felipe-mcarvalho/Embarcatech-3Fase/README.md

# SoC RISC-V com Acelerador AES-128 - Embarcatech 3ª Fase

Este repositório contém o projeto final da 3ª Fase do programa Embarcatech. O sistema consiste em um System-on-Chip (SoC) baseado no processador RISC-V (PicoRV32), integrado a um acelerador criptográfico de hardware para o algoritmo AES-128 e controlado externamente via interface serial (UART). O projeto foi sintetizado e validado fisicamente em uma FPGA Lattice ECP5 (Colorlight i9).

## Visão Geral do Projeto
Abaixo estão representados o diagrama da arquitetura lógica instanciada no SoC e a montagem física do sistema na placa FPGA.

Diagrama RTL
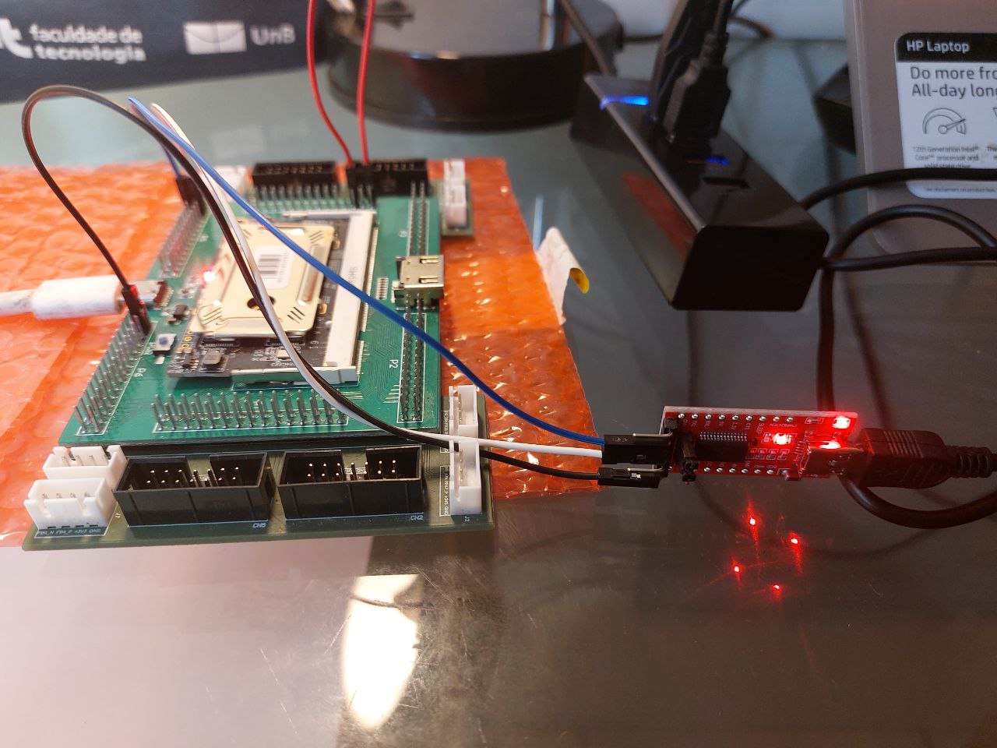
[picture p1: docs/img/placa1.jpg]
Foto do Projeto


---

## Estrutura do Repositório

- `rtl/`: Códigos-fonte em Verilog descrevendo o hardware (CPU, AES, UART, Interconexões).
- `firmware/`: Códigos em linguagem C e Linker Scripts executados pelo PicoRV32.
- `sim/`: Arquivos de testbench e simulação.
- `scripts/`: Scripts auxiliares de automação.
- `validation/`: Scripts em Python.
- `Makefile`: Automação da compilação do firmware.
- `docs/`: Documentação de referência, imagens e diagramas.

---

## Demonstrações em Vídeo
Clique nas thumbnails abaixo para visualizar os testes na placa:

Validação módulo AES (https://www.youtube.com/watch?v=sAaSfQWxbzg)
Validação RISC-V (https://www.youtube.com/watch?v=2NX07yqfi-U)

## Visão Física e Layout
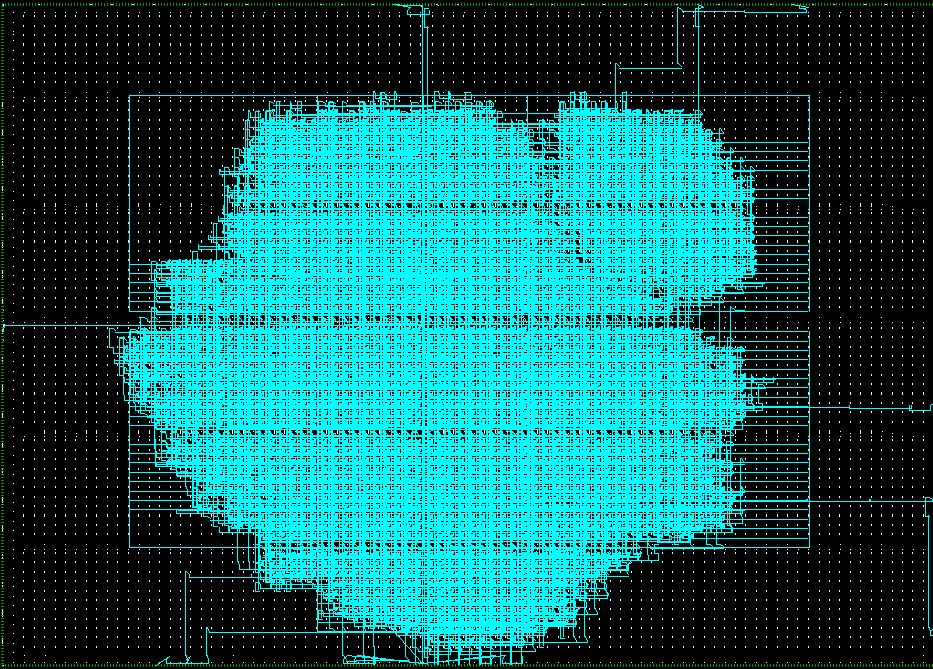
[picture p2: docs/img/soc_top_physical_view.png]
Physical View do SoC com o PicoRV32


## Simulação: Bloco AES
Validação dos vetores de teste matemáticos da criptografia.
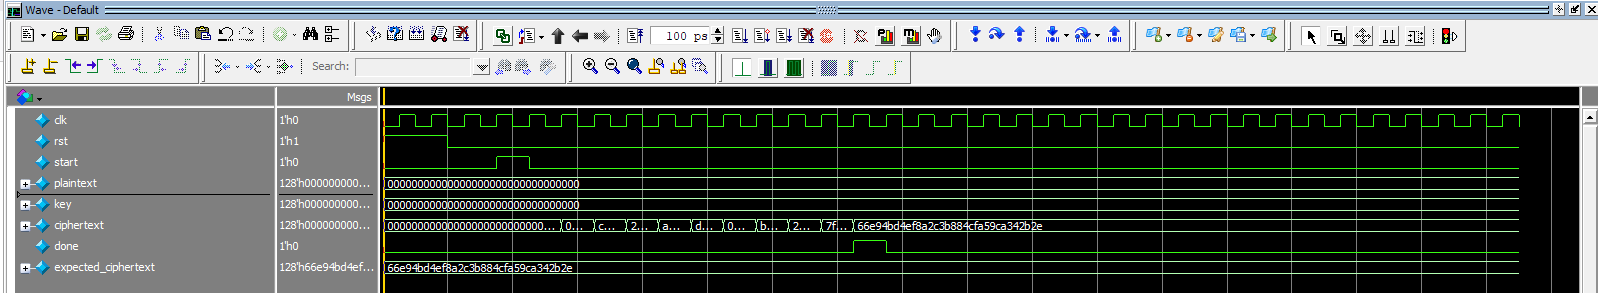
[picture p3: docs/img/tb_aes1.png]
Testbench AES 1

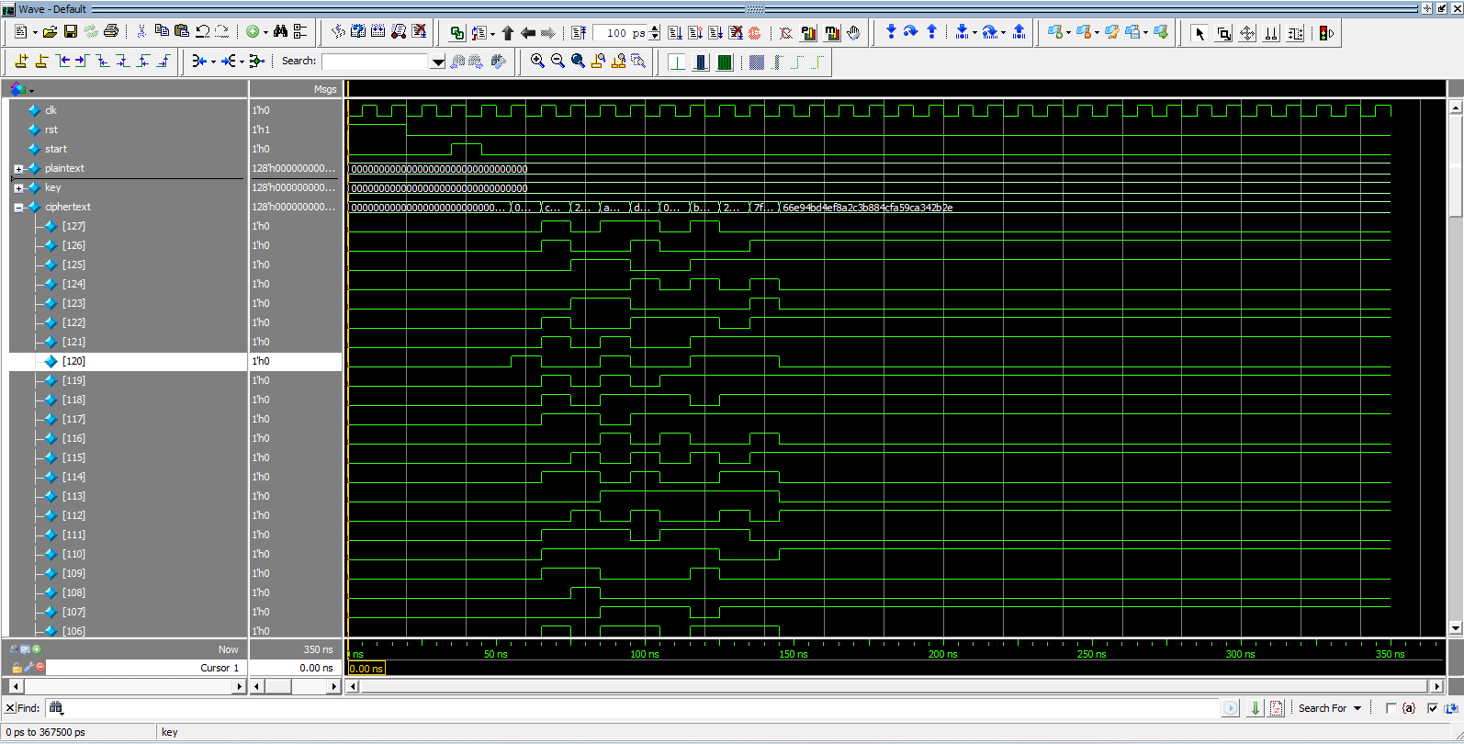
[picture p4: docs/img/tb_aes2.png]
Testbench AES 2

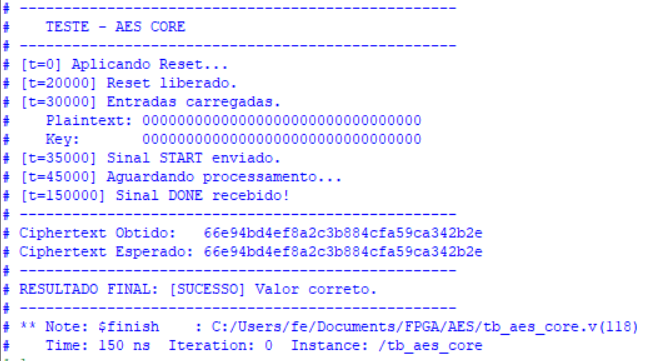
[picture p5: docs/img/tb_aes3.png]
Testbench AES 3


## Simulação: SoC PicoRV32
Execução de código e validação das instruções do processador RISC-V.
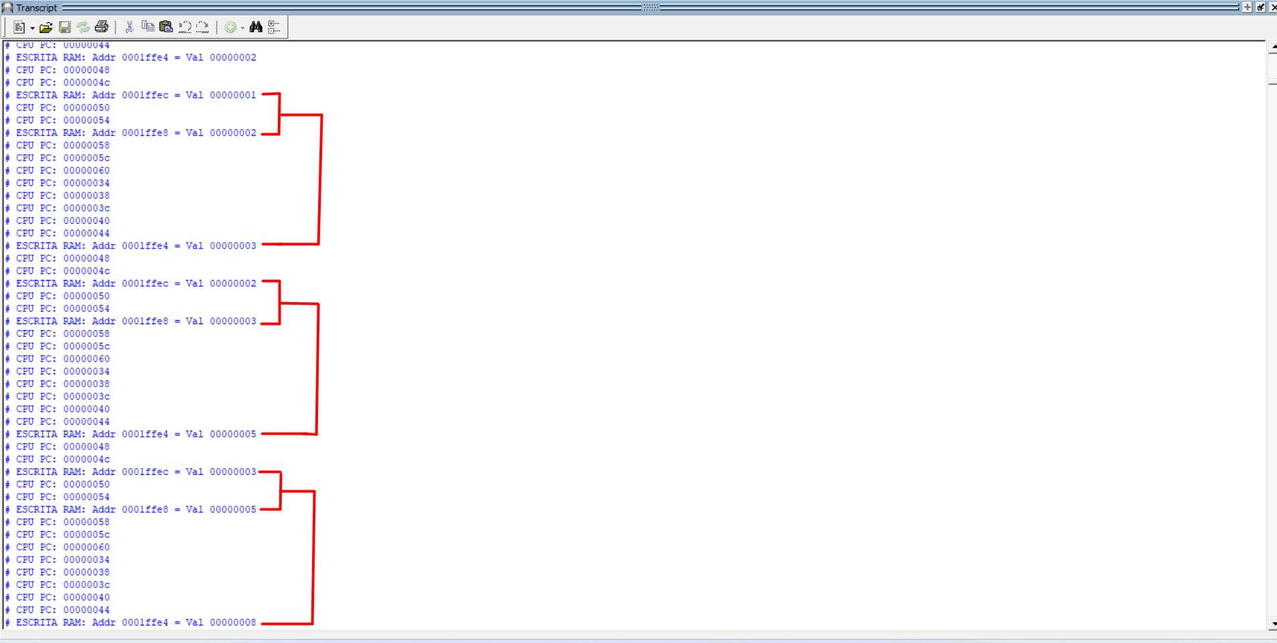
[picture p6: docs/img/tb_pico1.png]
Testbench PicoRV32 1

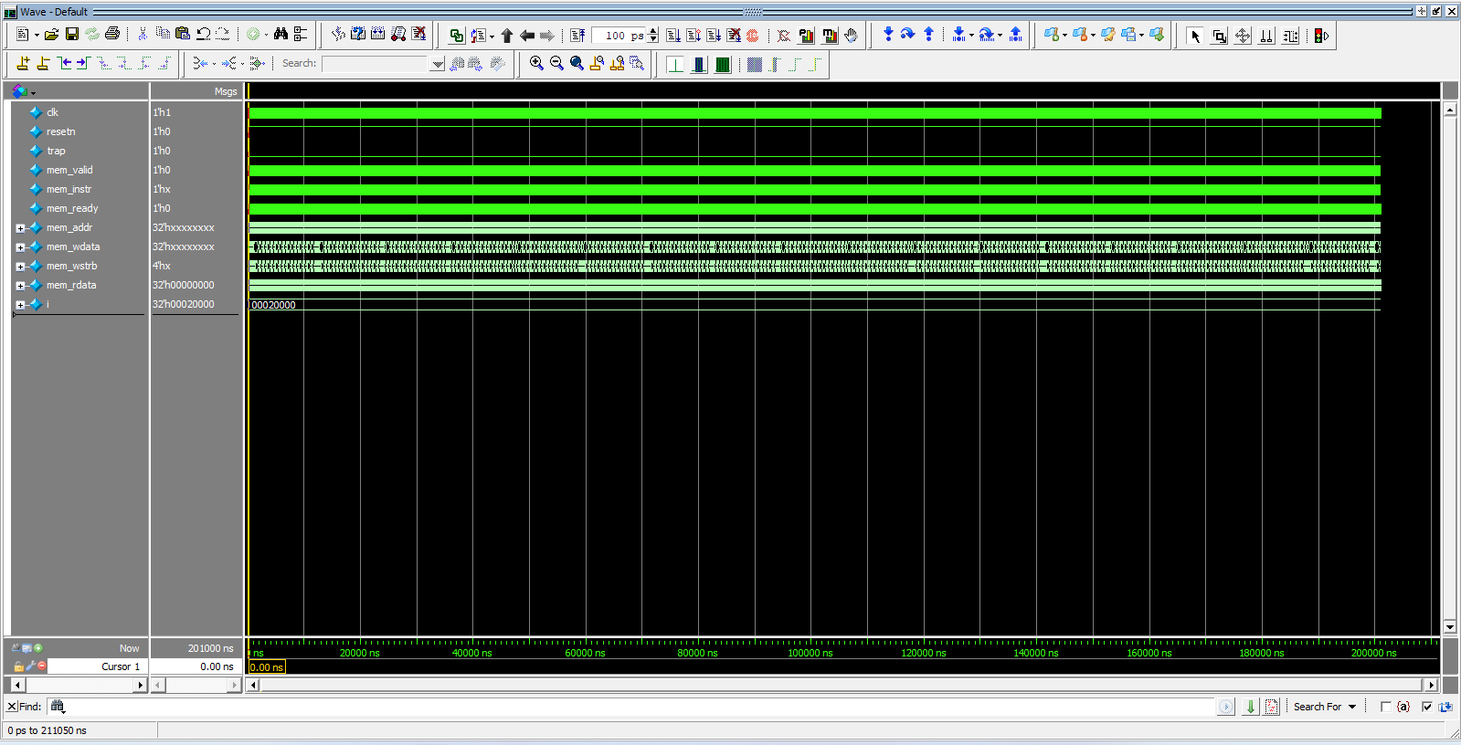
[picture p7: docs/img/tb_pico2.png]
Testbench PicoRV32 2

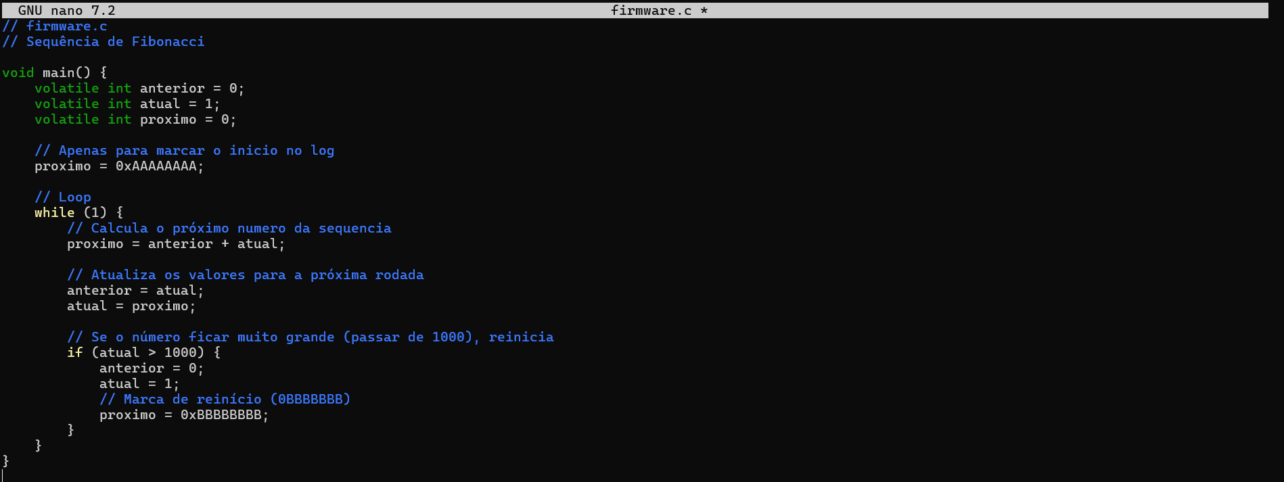
[picture p8: docs/img/tb_pico3.png]
Testbench PicoRV32 3


## Comunicação UART
Teste de transmissão e recepção serial.
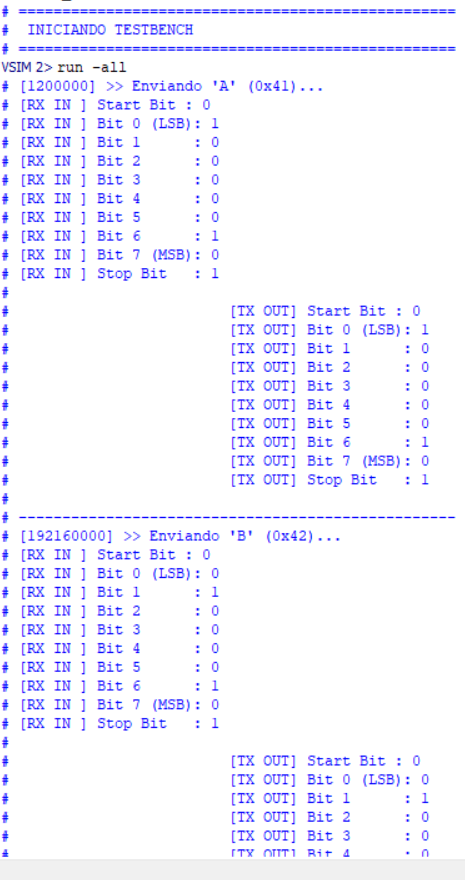
[picture p9: docs/img/tb_uart1.png]
Testbench UART

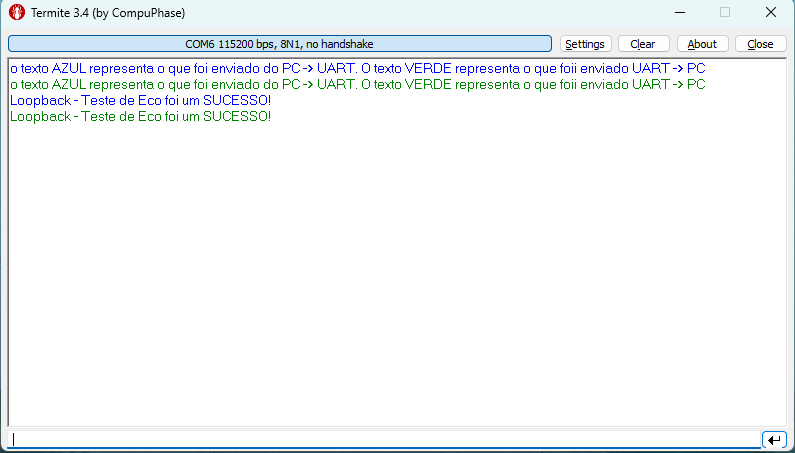
[picture p10: docs/img/teste_uart_sintetizada.png]
Teste UART sintetizada na colorlight-i9

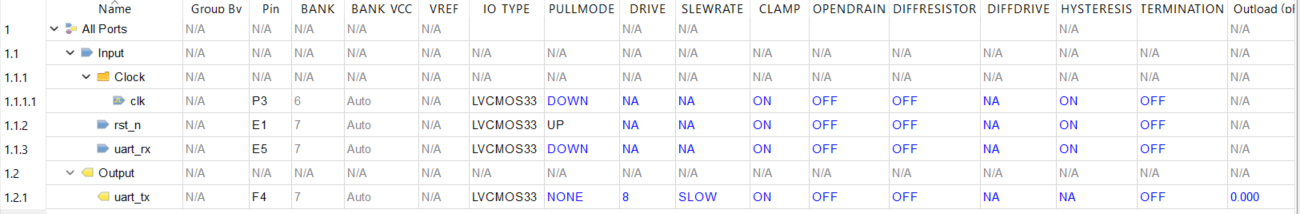
[picture p11: docs/img/pinagem_uart.png]
Pinagem UART


## Erros da Placa (Debug)
erro1
erro2
