felipe-mcarvalho/Embarcatech-3Fase/docs/add_round_key_rtl.pdf

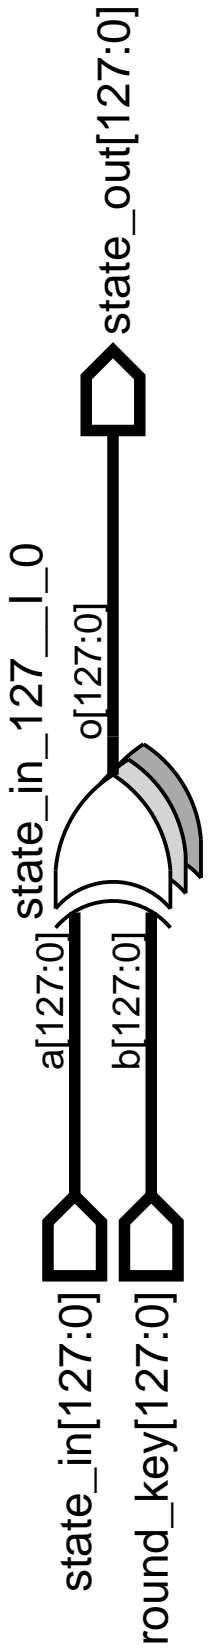
[picture p13: figure]
state_in[127:0]; state_in_127__I_0; round_key[127:0]; state_out[127:0]
