felipe-mcarvalho/Embarcatech-3Fase/docs/round_top_rtl.pdf

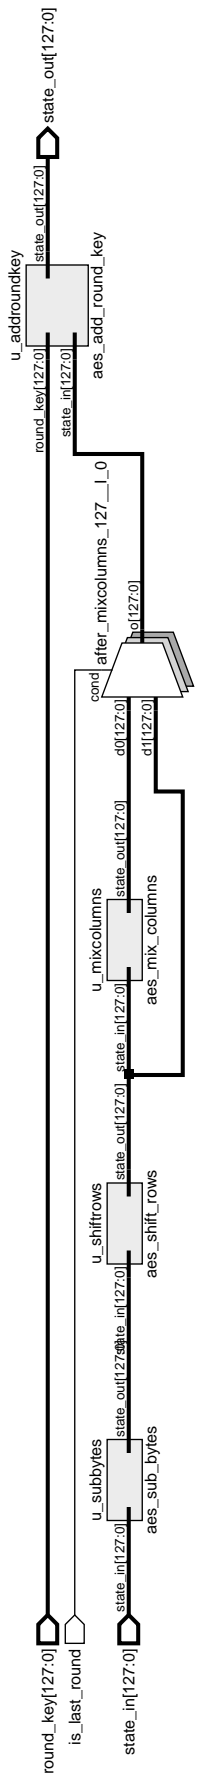
[picture p14: figure]
round_key[127:0]; is_last_round; u_addroundkey; aes_add_round_key; state_in[127:0]; round_key[127:0] state_out[127:0]; after_mixcolumns_127__I_0; cond; state_out[127:0]; u_subbytes; aes_sub_bytes; state_in[127:0] state_out[127:0]; u_shiftrows; aes_shift_rows; u_mixcolumns; aes_mix_columns

## state_in[127:0] state_out[127:0] state_in[127:0]
