felipe-mcarvalho/Embarcatech-3Fase/docs/xtime_rtl.pdf

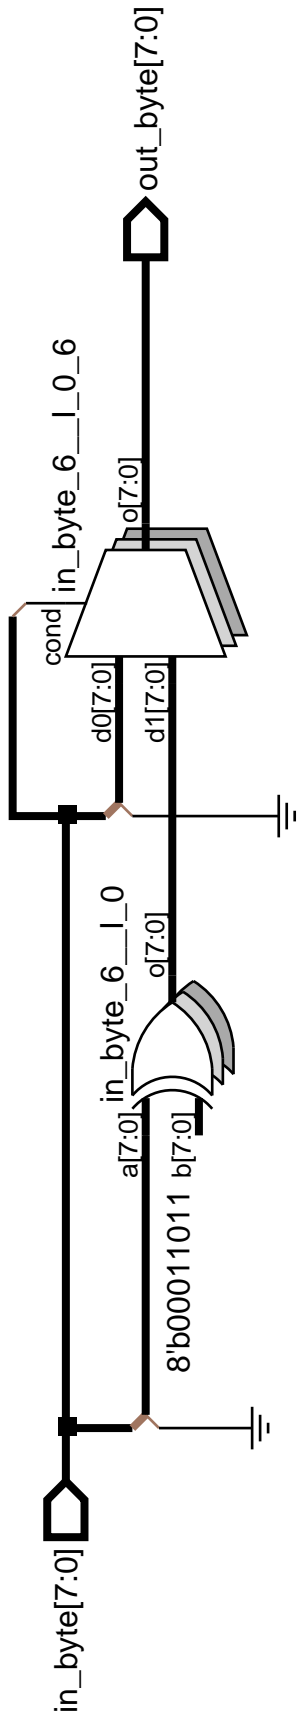
[picture p15: figure]
in_byte_6__I_0; in_byte[7:0]; out_byte[7:0]; in_byte_6__I_0_6; cond
