felipe-mcarvalho/Embarcatech-3Fase/docs/rtl_lattice.pdf

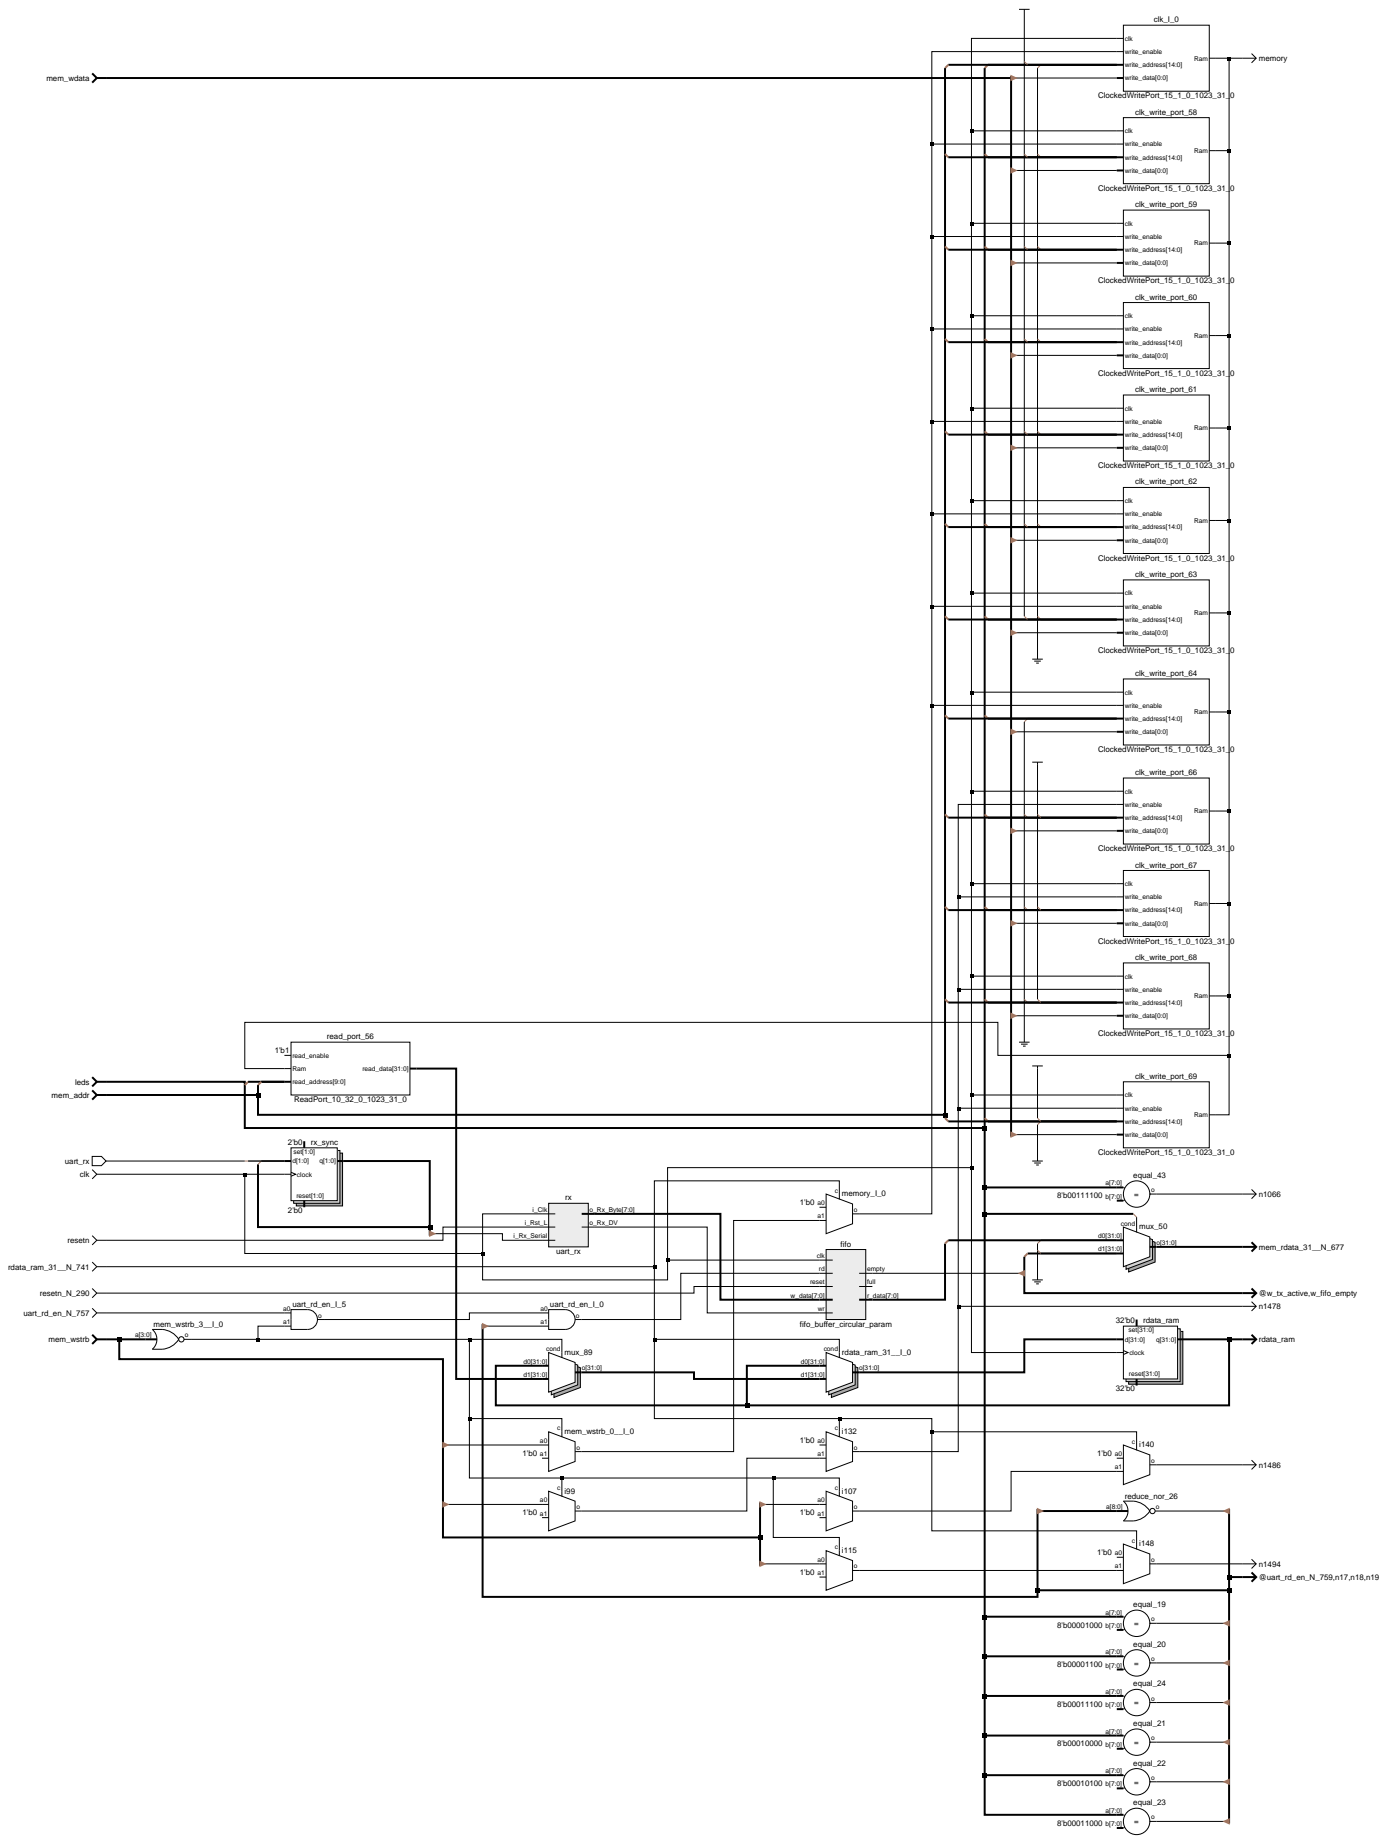
[picture p16: page 1]
clk_I_0; ClockedWritePort_15_1_0_1023_31_0; clk write_enable write_address[14:0] write_data[0:0]; Ram; clk_write_port_58; clk_write_port_59; clk_write_port_60; clk_write_port_61; clk_write_port_62; clk_write_port_63; clk_write_port_64; clk_write_port_66; clk_write_port_67; mem_wdata; clk_write_port_68; memory; clk_write_port_69; read_port_56; ReadPort_10_32_0_1023_31_0; read_enable 1'b1; read_data[31:0]; read_address[9:0] mem_addr; leds; uart_rx; i_Clk; i_Rst_L; i_Rx_Serial; o_Rx_Byte[7:0]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
