felipe-mcarvalho/Embarcatech-3Fase/docs/mixColumns_rtl.pdf

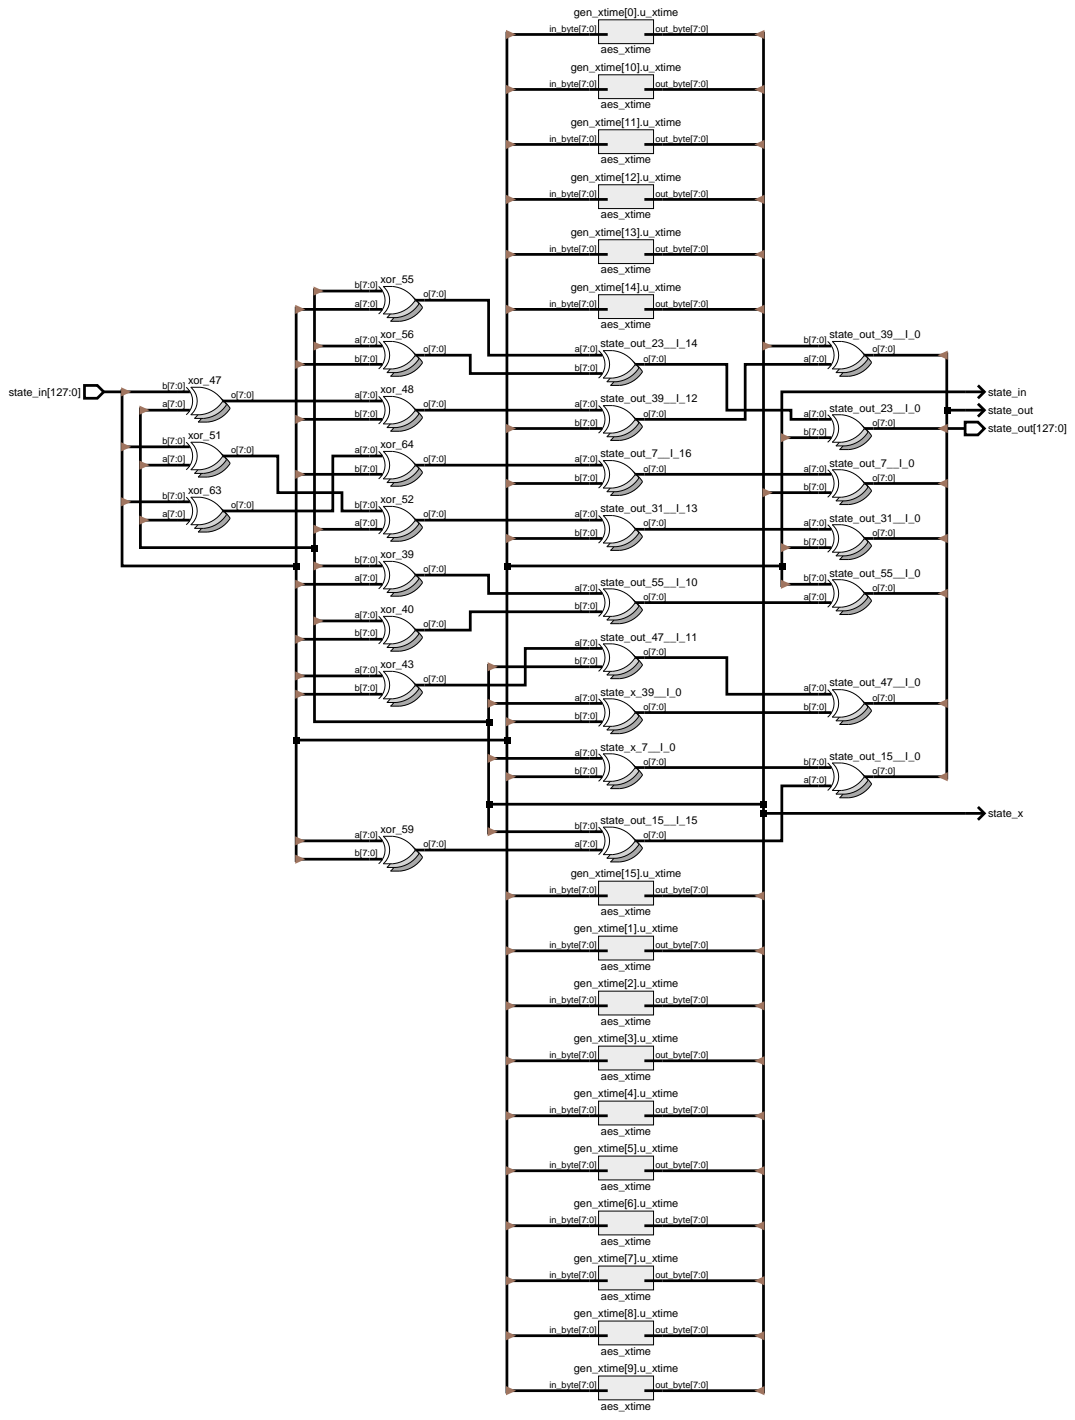
[picture p17: page 1]
gen_xtime[0].u_xtime; aes_xtime; in_byte[7:0]; out_byte[7:0]; gen_xtime[10].u_xtime; gen_xtime[11].u_xtime; gen_xtime[12].u_xtime; gen_xtime[13].u_xtime; gen_xtime[14].u_xtime; xor_55; xor_56 a[7:0]; state_out_23__I_14 a[7:0]; xor_48 a[7:0]; state_out_39__I_12 a[7:0]; state_out_39__I_0; state_in; state_out_23__I_0 a[7:0]; xor_47; xor_64 a[7:0]; xor_51; xor_52; state_out_7__I_16 a[7:0]; state_out_7__I_0 a[7:0]; xor_63; xor_39; state_out_31__I_13 a[7:0]; state_out_31__I_0 a[7:0]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
